SFUSatClub/z-panel/z-panel1.step

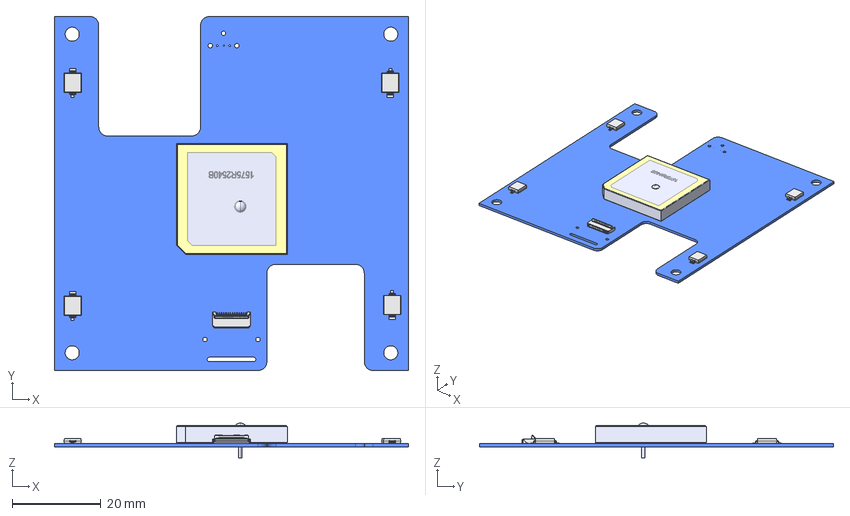
[picture p1: CAD file, 2018-03-22]
z-panel1.step
80.0 x 80.0 x 7.90 mm
