SFUSatClub/z-panel/z-panel.kicad_pcb

## KiCad design z-panel.kicad_pcb (2018-04-21)

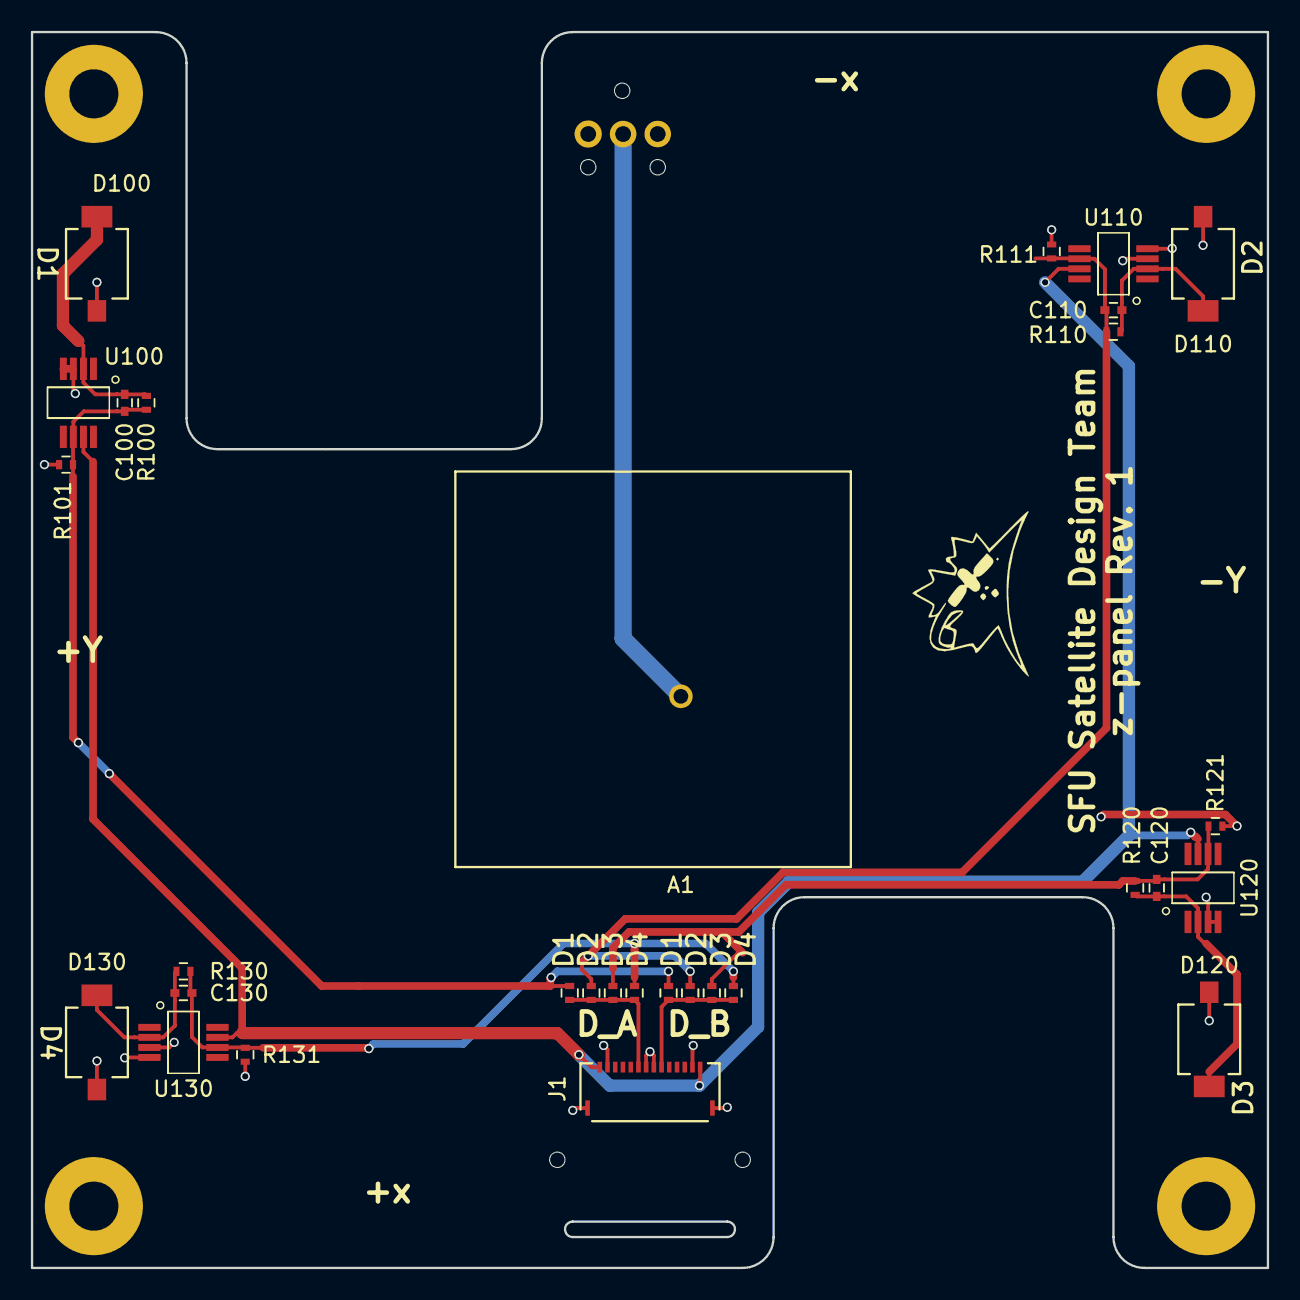
[picture p7: board z-panel.kicad_pcb from above]

Board: 2 copper layers, 80.0 x 80.0 mm, 37 parts (1 on the bottom side), 13 nets.

Parts:
A1: GPS_ANTENNA; GPS_ANT_4mm
C100, C110, C120, C130: 0.1uF; C_0402
D100, D110, D120, D130: D_Photo; SFH2430
J1: MOLEX_FFC-14
J2, J3, J4, J5: PC104PTH
J6: TEST_1P; vis-0.6mm
J7, J8: TEST_1P; via-0.97mm
R1, R2, R3, R4, R5, R6, R7, R8: 0R; R_0402
R100, R110, R120, R130: 2K2; R_0402
R101, R111, R121, R131: DNP; R_0402
U100, U110, U120, U130: OPA380; VSSOP_8

Connections:
/3V3: J1.1, J1.14, U100.7, U110.7, U120.7, U130.7
/D1: C100.1, R1.1, R2.1, R100.1, R101.1, U100.6
/D2: C110.1, R3.1, R4.1, R110.1, R111.1, U110.6
/D3: C120.1, R5.1, R6.1, R120.1, R121.1, U120.6
/D4: C130.1, R7.1, R8.1, R130.1, R131.1, U130.6
/D_A: J1.6, R1.2, R3.2, R5.2, R7.2
/D_B: J1.9, R2.2, R4.2, R6.2, R8.2
GND: D100.2, D110.2, D120.2, D130.2, J1.2, J1.7, J1.8, J1.13, J1.SHLD, J2.1, J3.1, J4.1, J5.1, J7.1, J8.1, R101.2, R111.2, R121.2, R131.2, U100.3, U100.4, U110.3, U110.4, U120.3, U120.4, U130.3, U130.4
unnamed: A1.1, J6.1
unnamed: C100.2, D100.1, R100.2, U100.2
unnamed: C110.2, D110.1, R110.2, U110.2
unnamed: C120.2, D120.1, R120.2, U120.2
unnamed: C130.2, D130.1, R130.2, U130.2
