SFUSatClub/z-panel/(threads)

Thread 1 (2018-03-31):

Coax entry

TobiNakamura, 2018-03-31:
GPS coax center core and ground shield entry should be PTH 1.02mm, 1.72mm

TobiNakamura, 2018-03-31:
mask layer needs to be enabled

Closed 2018-03-31.
