SFUSatClub/z-panel/(commit log)

2018-02-25 added 3d model for photodiode
    [z-panel.kicad_pcb]
2018-03-04 layout complete
    [Sun_Sensor.sch, z-panel.kicad_pcb, z-panel.sch, z-panel.step, z-panel1.step]
2018-03-22 added slots for coax access and adjusted FFC position
    [Sun_Sensor.sch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]
2018-03-22 added coordinates to silkscreen
    [z-panel-B.Cu.gbr, z-panel-B.Mask.gbr, z-panel-B.SilkS.gbr, z-panel-Edge.Cuts.gbr, z-panel-F.Cu.gbr, z-panel-F.Mask.gbr, z-panel-F.Paste.gbr, z-panel-F.SilkS.gbr]
2018-03-31 fixed GPS coax entry. Closes #1
    [z-panel.kicad_pcb]
2018-04-21 solder mask fixed to conform to min 150um webbing requirement
    [z-panel.kicad_pcb]
2018-04-23 generated gerbers
    [z-panel-B.Cu.gbr, z-panel-B.Mask.gbr, z-panel-B.SilkS.gbr, z-panel-Edge.Cuts.gbr, z-panel-F.Cu.gbr, z-panel-F.Mask.gbr, z-panel-F.SilkS.gbr, z-panel-NPTH.drl]
2018-06-02 made schematic
